grumble1965/FaradayRF-Hardware/Kicad-Faraday/ADC_Filters.sch

## KiCad design Kicad-Faraday/ADC_Filters.sch (2016-11-02)

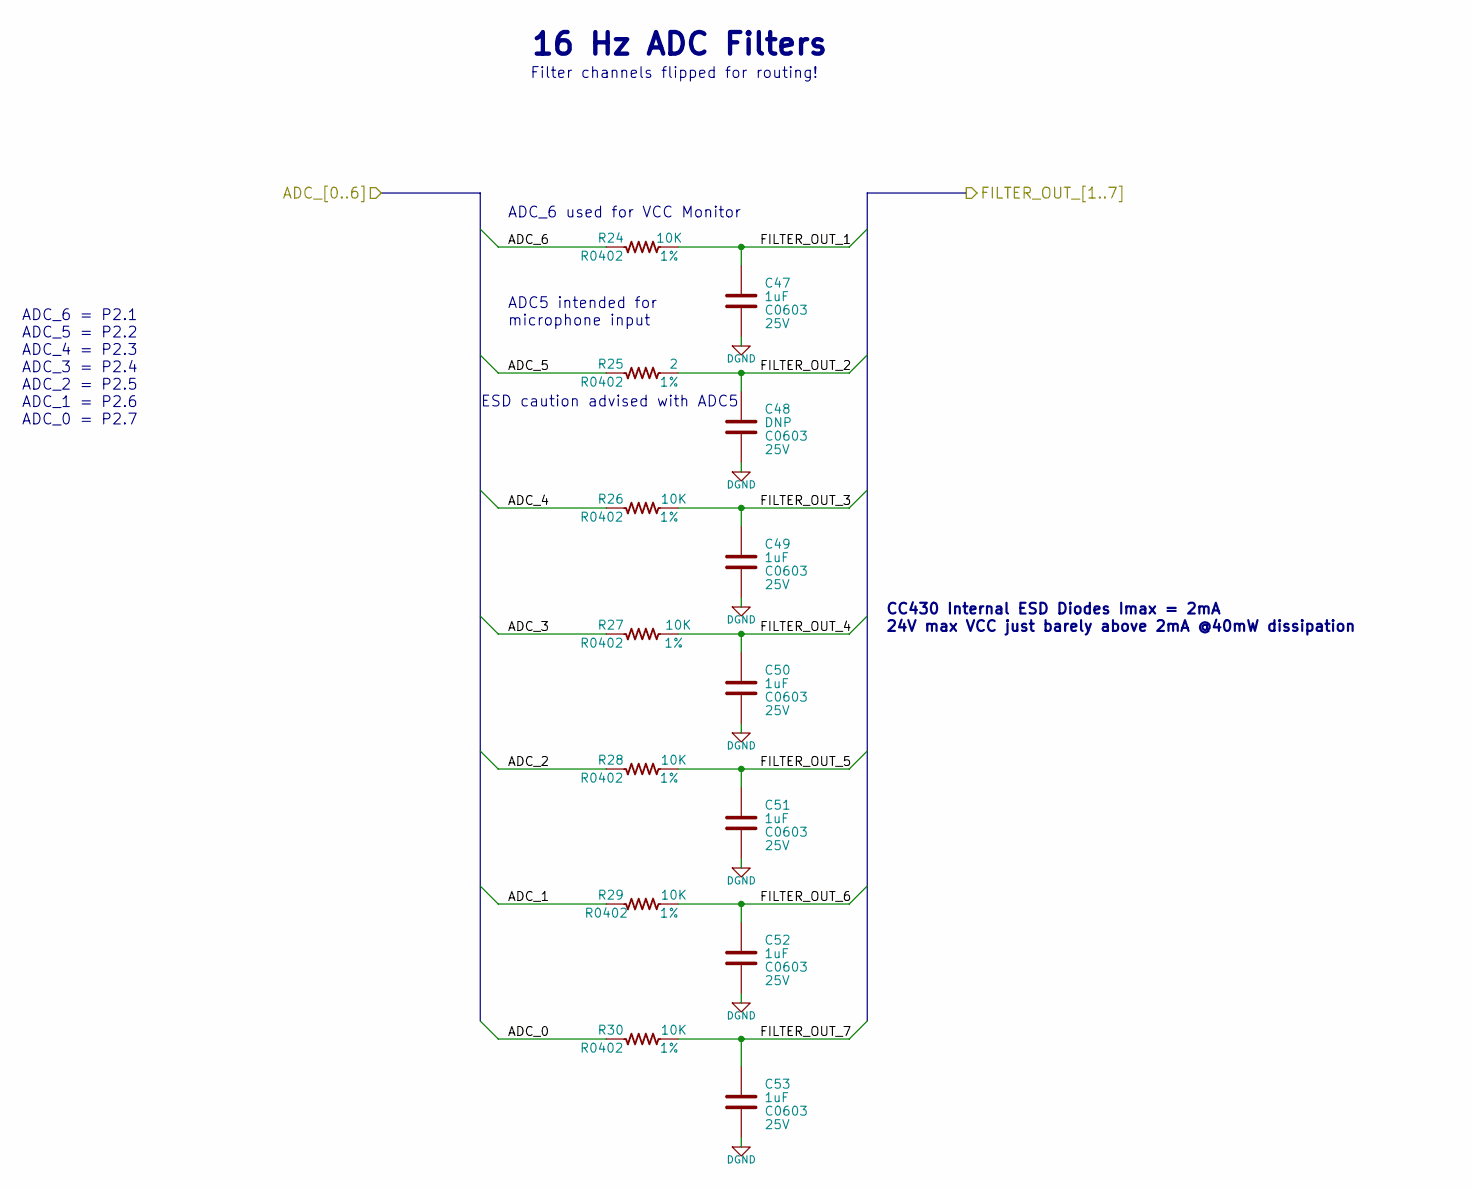
[picture p1: schematic ADC_Filters.sch]

Parts:
C47, C49, C50, C51, C52, C53: 1uF; C0603; Voltage 25V
C48: DNP; C0603; Voltage 25V
R24, R26, R27, R28, R29, R30: 10K; R0402; Tolerance 1%
R25: 2; R0402; Tolerance 1%

Connections:
ADC_0: R30.1
ADC_1: R29.1
ADC_2: R28.1
ADC_3: R27.1
ADC_4: R26.1
ADC_5: R25.1
ADC_6: R24.1
DGND: C47.2, C48.2, C49.2, C50.2, C51.2, C52.2, C53.2
FILTER_OUT_1: C47.1, R24.2
FILTER_OUT_2: C48.1, R25.2
FILTER_OUT_3: C49.1, R26.2
FILTER_OUT_4: C50.1, R27.2
FILTER_OUT_5: C51.1, R28.2
FILTER_OUT_6: C52.1, R29.2
FILTER_OUT_7: C53.1, R30.2

Notes on the sheet:
16 Hz ADC Filters
CC430 Internal ESD Diodes Imax = 2mA 24V max VCC just barely above 2mA @40mW dissipation
Filter channels flipped for routing!
ADC_6 used for VCC Monitor
ADC_6 = P2.1 ADC_5 = P2.2 ADC_4 = P2.3 ADC_3 = P2.4 ADC_2 = P2.5 ADC_1 = P2.6 ADC_0 = P2.7
ADC5 intended for microphone input
ESD caution advised with ADC5
