grumble1965/FaradayRF-Hardware/Kicad-Faraday/CC430.sch

## KiCad design Kicad-Faraday/CC430.sch (2016-11-02)

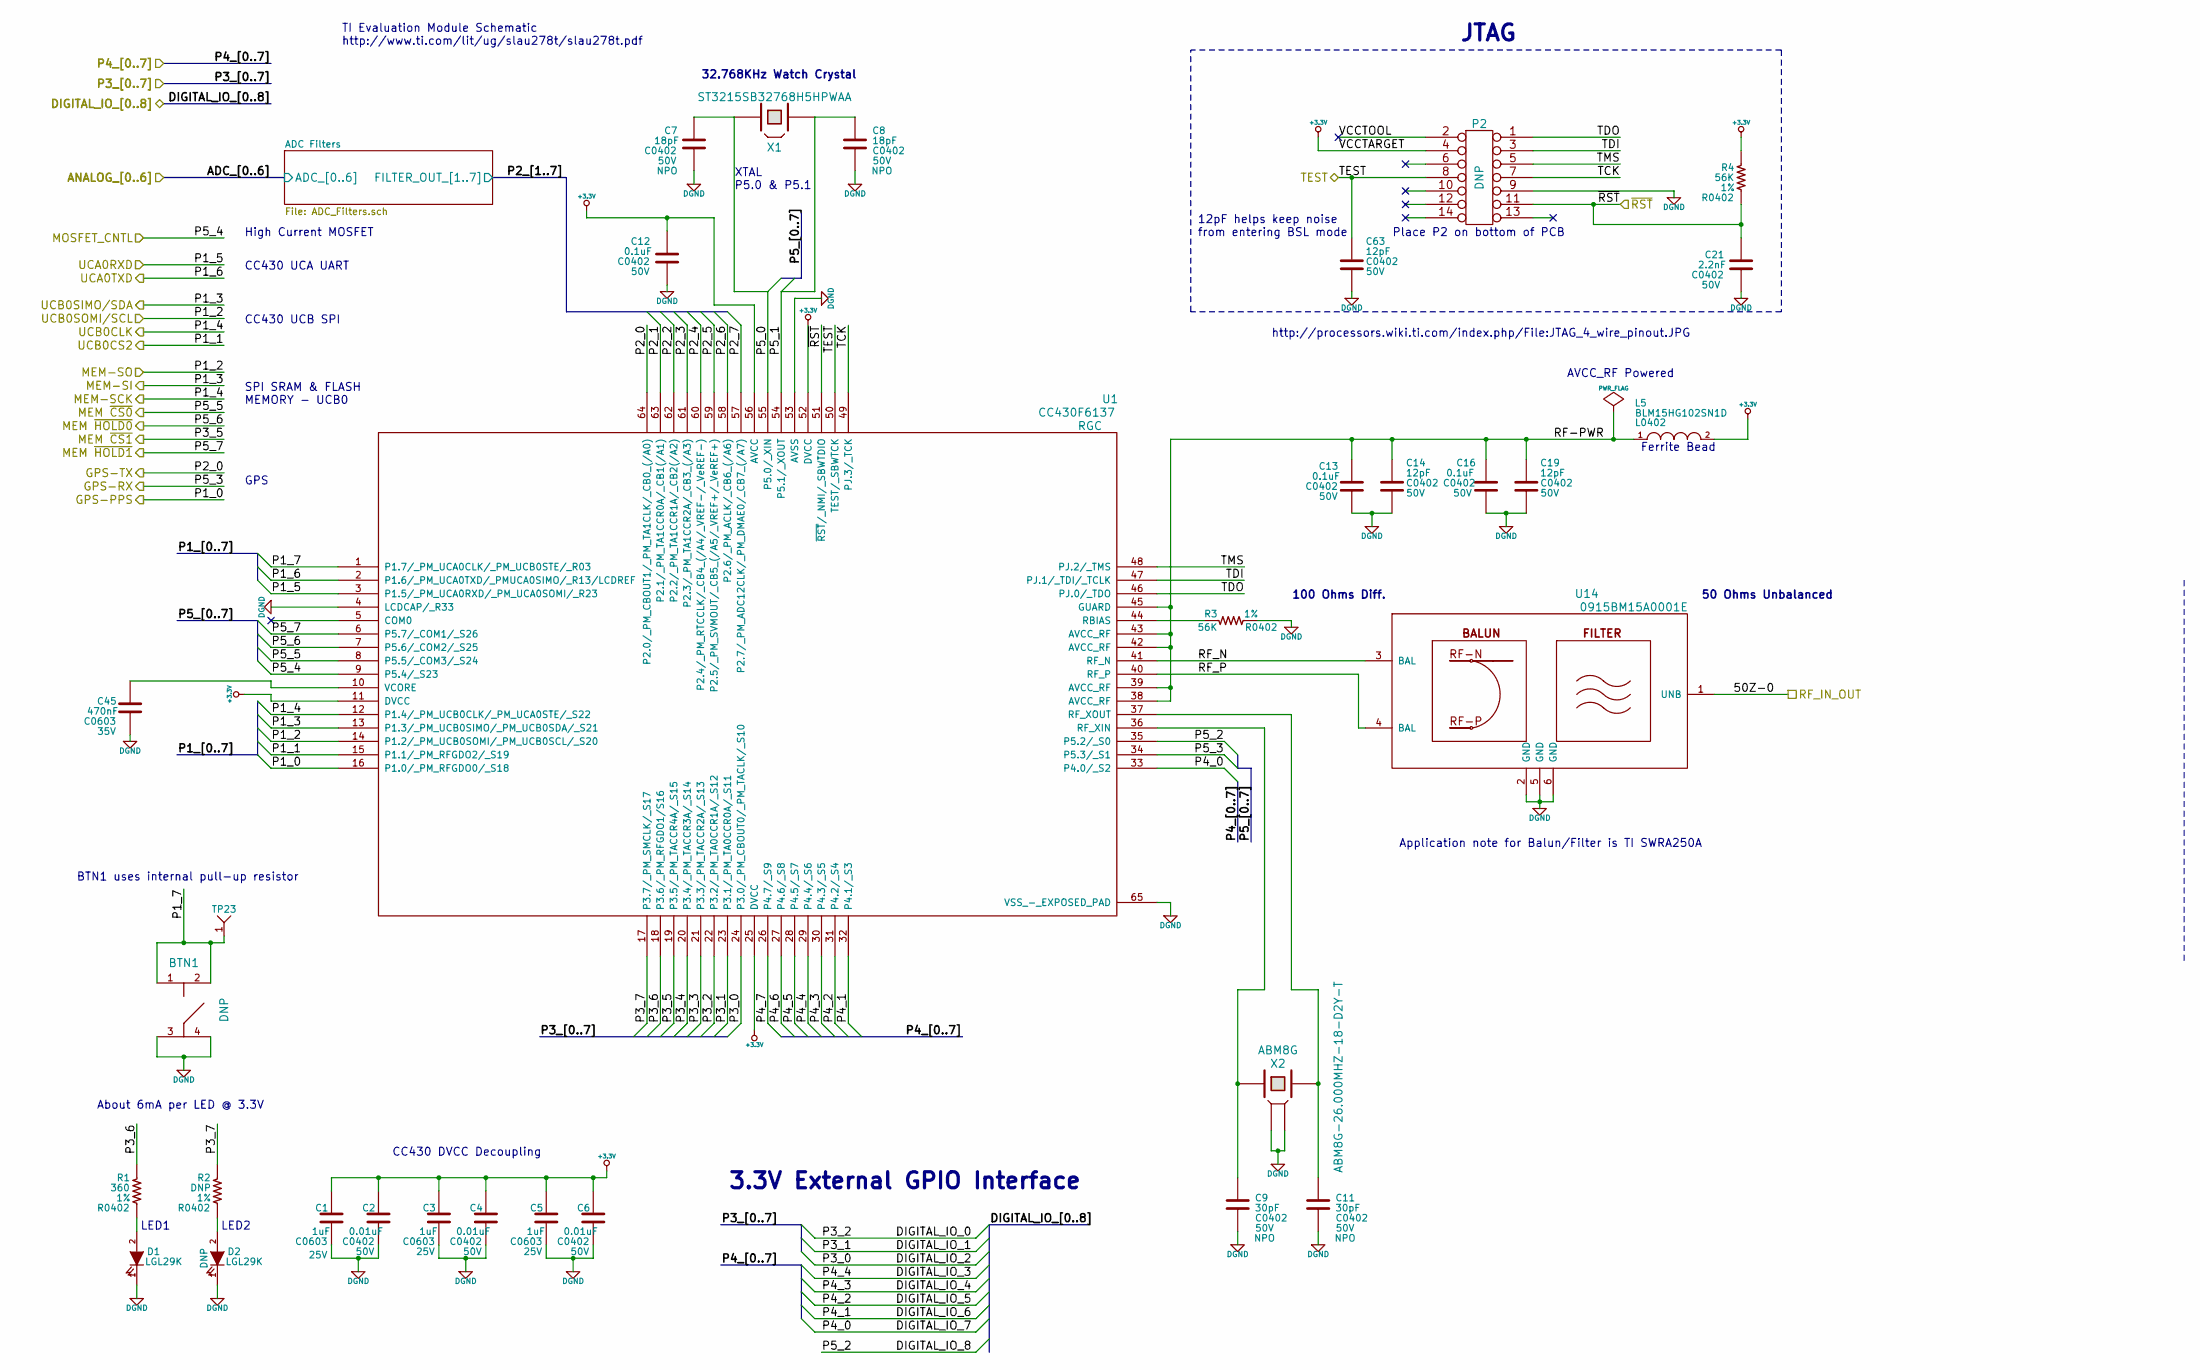
[picture p2: schematic CC430.sch]

Parts:
BTN1: DNP; PTS645-SMD
C1, C3, C5: 1uF; C0603; Voltage 25V
C2, C4, C6: 0.01uF; C0402; Voltage 50V
C7, C8: 18pF; C0402; Voltage 50V; Rating NPO
C9, C11: 30pF; C0402; Voltage 50V; Rating NPO
C12, C13, C16: 0.1uF; C0402; Voltage 50V
C14, C19, C63: 12pF; C0402; Voltage 50V
C21: 2.2nF; C0402; Voltage 50V
C45: 470nF; C0603; Voltage 35V
D1: LED-IPC; LGL29K
D2: DNP; LGL29K
L5: BLM15HG102SN1D; L0402
P2: DNP; 2514-6002UB
R1: 360; R0402; Tolerance 1%
R2: DNP; R0402; Tolerance 1%
R3, R4: 56K; R0402; Tolerance 1%
TP23: TEST-POINT; TEST-POINT-42MIL
U1: CC430F6137; RGC
U14: 0915BM15A0001E
X1: ST3215SB32768H5HPWAA
X2: ABM8G-26.000MHZ-18-D2Y-T; ABM8G

Connections:
50Z-0: U14.1 (UNB)
+3.3V: C1.1, C2.1, C3.1, C4.1, C5.1, C6.1, C12.1, L5.2, P2.4, R4.1, U1.11 (DVCC), U1.25 (DVCC), U1.52 (DVCC), U1.56 (AVCC)
DGND: BTN1.3, BTN1.4, C1.2, C2.2, C3.2, C4.2, C5.2, C6.2, C7.2, C8.2, C9.2, C11.2, C12.2, C13.2, C14.2, C16.2, C19.2, C21.2, C45.2, C63.2, D1.1 (C), D2.1 (C), P2.9, R3.2, U1.4 (LCDCAP/_R33), U1.53 (AVSS), U1.65 (VSS_-_EXPOSED_PAD), U14.2 (GND), U14.5 (GND), U14.6 (GND), X2.2, X2.4
DIGITAL_IO_0: U1.22 (P3.2/_PM_TA0CCR1A/_S12)
DIGITAL_IO_1: U1.23 (P3.1/_PM_TA0CCR0A/_S11)
DIGITAL_IO_2: U1.24 (P3.0/_PM_CBOUT0/_PM_TACLK/_S10)
DIGITAL_IO_3: U1.29 (P4.4/_S6)
DIGITAL_IO_4: U1.30 (P4.3/_S5)
DIGITAL_IO_5: U1.31 (P4.2/_S4)
DIGITAL_IO_6: U1.32 (P4.1/_S3)
DIGITAL_IO_7: U1.33 (P4.0/_S2)
DIGITAL_IO_8: U1.35 (P5.2/_S0)
GPS-PPS: U1.16 (P1.0/_PM_RFGDO0/_S18)
GPS-RX: U1.34 (P5.3/_S1)
GPS-TX: U1.64 (P2.0/_PM_CBOUT1/_PM_TA1CLK/_CB0_(/A0))
MEM ~CS0~: U1.8 (P5.5/_COM3/_S24)
MEM ~CS1~: U1.19 (P3.5/_PM_TACCR4A/_S15)
MEM ~HOLD0~: U1.7 (P5.6/_COM2/_S25)
MEM ~HOLD1~: U1.6 (P5.7/_COM1/_S26)
MEM-SCK: U1.12 (P1.4/_PM_UCB0CLK/_PM_UCA0STE/_S22)
MEM-SI: U1.13 (P1.3/_PM_UCB0SIMO/_PM_UCB0SDA/_S21)
MEM-SO: U1.14 (P1.2/_PM_UCB0SOMI/_PM_UCB0SCL/_S20)
MOSFET_CNTL: U1.9 (P5.4/_S23)
unnamed: C9.1, U1.36 (RF_XIN), X2.1
unnamed: C11.1, U1.37 (RF_XOUT), X2.3
unnamed: C45.1, U1.10 (VCORE)
unnamed: D1.2 (A), R1.2
unnamed: D2.2 (A), R2.2
unnamed: R3.1, U1.44 (RBIAS)
P1_1: U1.15 (P1.1/_PM_RFGDO2/_S19)
P1_5: U1.3 (P1.5/_PM_UCA0RXD/_PM_UCA0SOMI/_R23)
P1_6: U1.2 (P1.6/_PM_UCA0TXD/_PMUCA0SIMO/_R13/LCDREF)
P1_7: BTN1.1, BTN1.2, TP23.1, U1.1 (P1.7/_PM_UCA0CLK/_PM_UCB0STE/_R03)
P2_1: U1.63 (P2.1/_PM_TA1CCR0A/_CB1(/A1))
P2_2: U1.62 (P2.2/_PM_TA1CCR1A/_CB2(/A2))
P2_3: U1.61 (P2.3/_PM_TA1CCR2A/_CB3_(/A3))
P2_4: U1.60 (P2.4/_PM_RTCCLK/_CB4_(/A4/_VREF-/_VeREF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)
P2_5: U1.59 (P2.5/_PM_SVMOUT/_CB5_(/A5/_VREF+/_VeREF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)
P2_6: U1.58 (P2.6/_PM_ACLK/_CB6_(/A6))
P2_7: U1.57 (P2.7/_PM_ADC12CLK/_PM_DMAE0/_CB7_(/A7))
P3_3: U1.21 (P3.3/_PM_TACCR2A/_S13)
P3_4: U1.20 (P3.4/_PM_TACCR3A/_S14)
P3_6: R1.1, U1.18 (P3.6/_PM_RFGDO1/S16)
P3_7: R2.1, U1.17 (P3.7/_PM_SMCLK/_S17)
P4_5: U1.28 (P4.5/_S7)
P4_6: U1.27 (P4.6/_S8)
P4_7: U1.26 (P4.7/_S9)
P5_0: C7.1, U1.55 (P5.0/_XIN), X1.1
P5_1: C8.1, U1.54 (P5.1/_XOUT), X1.2
RF-PWR: C13.1, C14.1, C16.1, C19.1, L5.1, U1.38 (AVCC_RF), U1.39 (AVCC_RF), U1.42 (AVCC_RF), U1.43 (AVCC_RF), U1.45 (GUARD)
RF_N: U1.41 (RF_N), U14.3 (BAL)
RF_P: U1.40 (RF_P), U14.4 (BAL)
TCK: P2.7, U1.49 (PJ.3/_TCK)
TDI: P2.3, U1.47 (PJ.1/_TDI/_TCLK)
TDO: P2.1, U1.46 (PJ.0/_TDO)
TEST: C63.1, P2.8, U1.50 (TEST/_SBWTCK)
TMS: P2.5, U1.48 (PJ.2/_TMS)
VCCTOOL: P2.2
~RST~: C21.1, P2.11, R4.2, U1.51 (~RST~/_NMI/_SBWTDIO)

Notes on the sheet:
JTAG
CC430 UCA UART
CC430 UCB SPI
CC430 DVCC Decoupling
50 Ohms Unbalanced
AVCC_RF Powered
http://processors.wiki.ti.com/index.php/File:JTAG_4_wire_pinout.JPG
BTN1 uses internal pull-up resistor
LED1
LED2
TI Evaluation Module Schematic http://www.ti.com/lit/ug/slau278t/slau278t.pdf
About 6mA per LED @ 3.3V
3.3V External GPIO Interface
XTAL P5.0 & P5.1
32.768KHz Watch Crystal
Ferrite Bead
GPS
SPI SRAM & FLASH MEMORY - UCB0
High Current MOSFET
Place P2 on bottom of PCB
12pF helps keep noise from entering BSL mode
Application note for Balun/Filter is TI SWRA250A
100 Ohms Diff.
