grumble1965/FaradayRF-Hardware/Kicad-Faraday/FLASH.sch

## KiCad design Kicad-Faraday/FLASH.sch (2016-11-02)

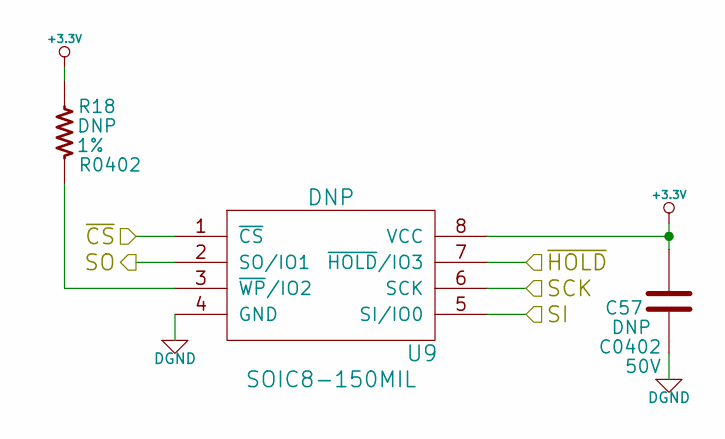
[picture p3: schematic FLASH.sch]

Parts:
C46: DNP; C0402; Voltage 50V
R18: DNP; R0402; Tolerance 1%
U9: DNP; SOIC8-150MIL

Connections:
+3.3V: C46.1, R18.2, U9.8 (VCC)
DGND: C46.2, U9.4 (GND)
unnamed: R18.1, U9.3 (~WP~/IO2)
SCK: U9.6 (SCK)
SI: U9.5 (SI/IO0)
SO: U9.2 (SO/IO1)
~CS~: U9.1 (~CS~)
~HOLD~: U9.7 (~HOLD~/IO3)
