grumble1965/FaradayRF-Hardware/Kicad-Faraday/Faraday.sch

## KiCad design Kicad-Faraday/Faraday.sch (2016-11-02)

Schematic: Faraday.sch

Parts:
FD1, FD2, FD3, FD4, FD5, FD6: FIDUCIAL; FD1
G1: OSHW
G2: FARADAYRF; FaradayRF
HDWR1, HDWR4, HDWR5, HDWR6: MOUSEBITE; BREAKAWAY-MIDDLE
P1: RF_FEMALE; CONSMA001-SMD-G

Notes on the sheet:
TX/RX referenced per chip CC430 RX <- FT230X TX CC430 TX -> FT230X RX
RF & Control Section
Connectors
USB <-> UART
Voltage Regulator
FaradayRF Wireless Module
SMA Connector
GPS Receiver
Manufacturing
