grumble1965/FaradayRF-Hardware/Kicad-Faraday/GPS.sch

## KiCad design Kicad-Faraday/GPS.sch (2016-11-02)

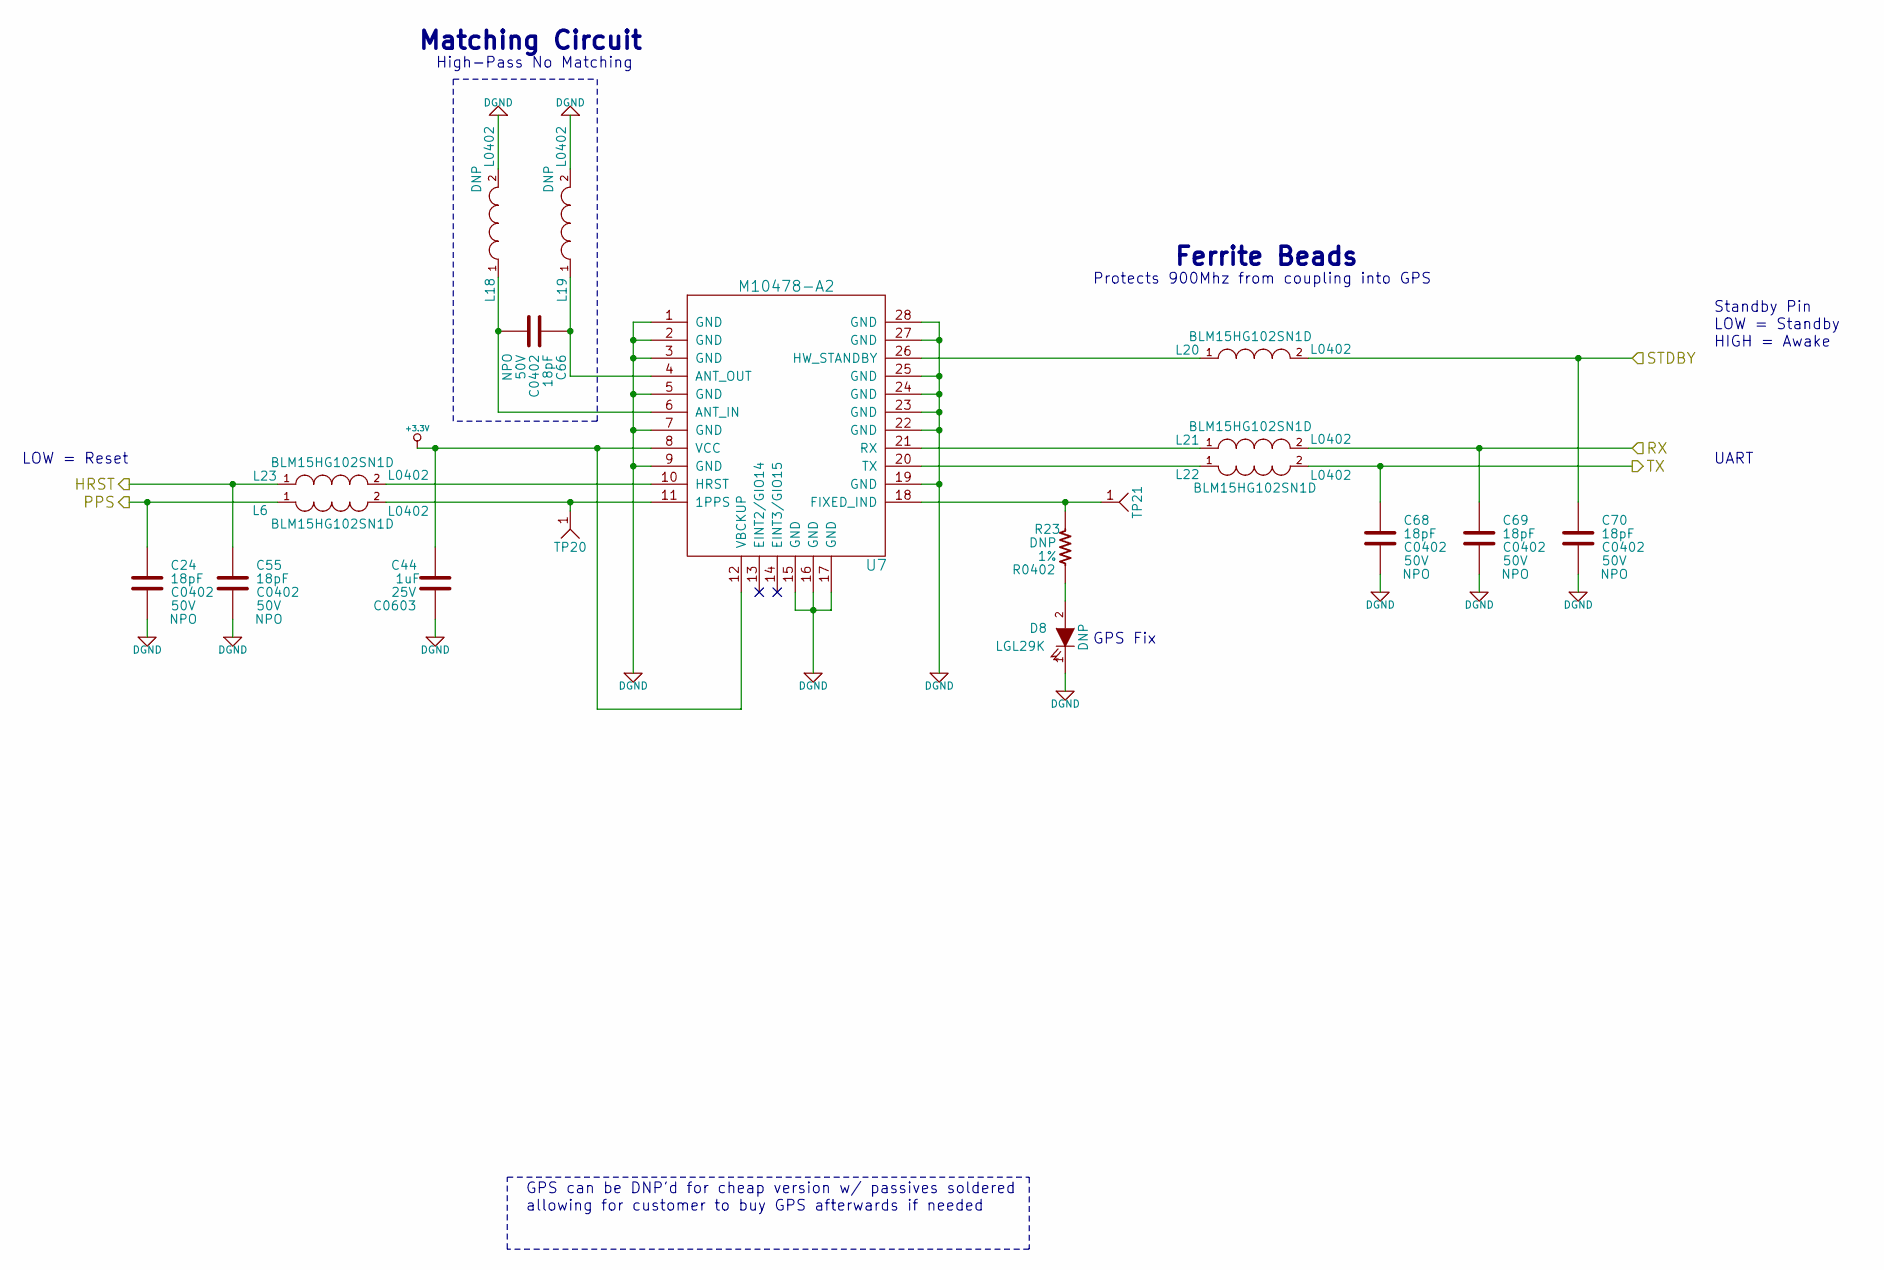
[picture p4: schematic GPS.sch]

Parts:
C24, C55, C66, C68, C69, C70: 18pF; C0402; Voltage 50V; Rating NPO
C44: 1uF; C0603; Voltage 25V
D8: DNP; LGL29K
L6, L20, L21, L22, L23: BLM15HG102SN1D; L0402
L18, L19: DNP; L0402
R23: DNP; R0402; Tolerance 1%
TP20, TP21: TEST-POINT; TEST-POINT-42MIL
U7: M10478-A2

Connections:
+3.3V: C44.1, U7.8 (VCC), U7.12 (VBCKUP)
DGND: C24.2, C44.2, C55.2, C68.2, C69.2, C70.2, D8.1 (C), L18.2, L19.2, U7.1 (GND), U7.2 (GND), U7.3 (GND), U7.5 (GND), U7.7 (GND), U7.9 (GND), U7.15 (GND), U7.16 (GND), U7.17 (GND), U7.19 (GND), U7.22 (GND), U7.23 (GND), U7.24 (GND), U7.25 (GND), U7.27 (GND), U7.28 (GND)
HRST: C55.1, L23.1
unnamed: C66.1, L19.1, U7.4 (ANT_OUT)
unnamed: C66.2, L18.1, U7.6 (ANT_IN)
unnamed: D8.2 (A), R23.2
unnamed: L6.2, TP20.1, U7.11 (1PPS)
unnamed: L20.1, U7.26 (HW_STANDBY)
unnamed: L21.1, U7.21 (RX)
unnamed: L22.1, U7.20 (TX)
unnamed: L23.2, U7.10 (HRST)
unnamed: R23.1, TP21.1, U7.18 (FIXED_IND)
PPS: C24.1, L6.1
RX: C69.1, L21.2
STDBY: C70.1, L20.2
TX: C68.1, L22.2

Notes on the sheet:
Ferrite Beads
GPS can be DNP'd for cheap version w/ passives soldered allowing for customer to buy GPS afterwards if needed
UART
Matching Circuit
High-Pass No Matching
Protects 900Mhz from coupling into GPS
Standby Pin LOW = Standby HIGH = Awake
GPS Fix
LOW = Reset
