grumble1965/FaradayRF-Hardware/Kicad-Faraday/MOSFET.sch

## KiCad design Kicad-Faraday/MOSFET.sch (2016-11-02)

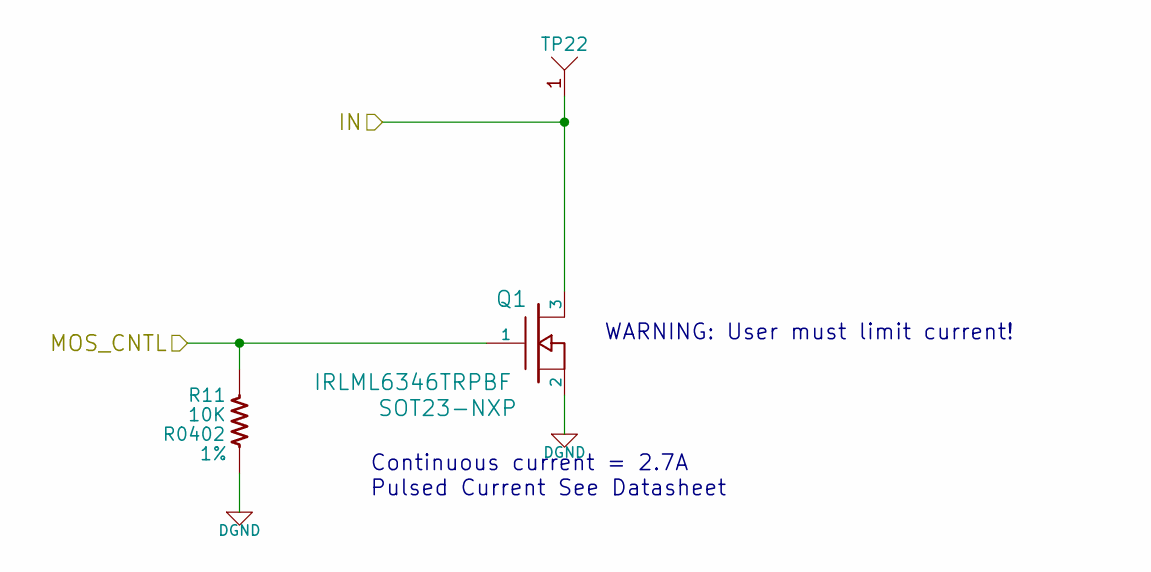
[picture p5: schematic MOSFET.sch]

Parts:
Q1: IRLML6346TRPBF; SOT23-NXP
R11: 10K; R0402; Tolerance 1%
TP22: TEST-POINT; TEST-POINT-42MIL

Connections:
DGND: Q1.2, R11.2
IN: Q1.3, TP22.1
MOS_CNTL: Q1.1, R11.1

Notes on the sheet:
WARNING: User must limit current!
Continuous current = 2.7A Pulsed Current See Datasheet
