grumble1965/FaradayRF-Hardware/Kicad-Faraday/PowerSupply.sch

## KiCad design Kicad-Faraday/PowerSupply.sch (2016-11-02)

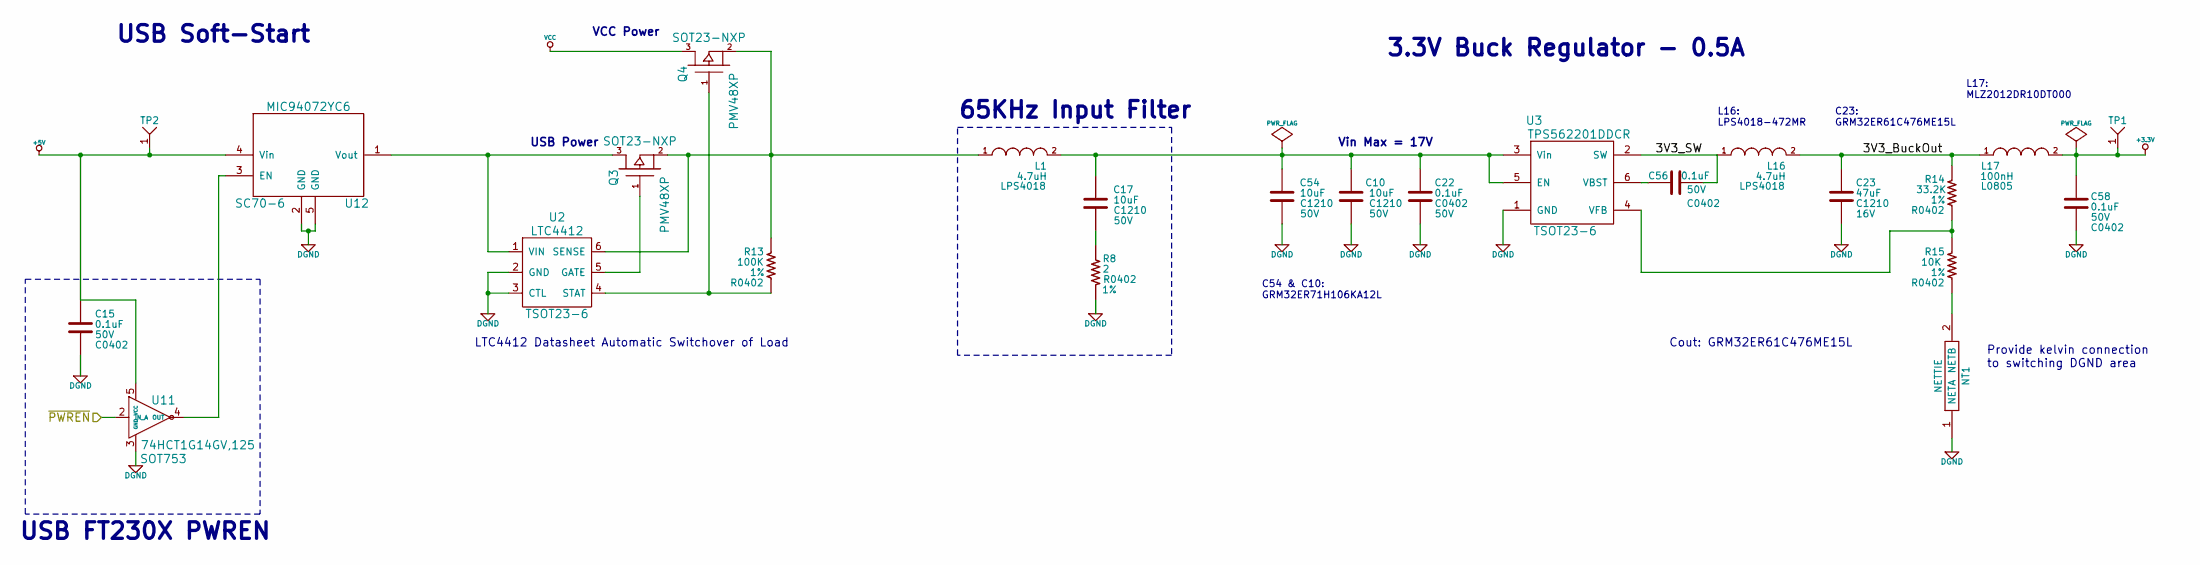
[picture p6: schematic PowerSupply.sch]

Parts:
C10, C17, C54: 10uF; C1210; Voltage 50V
C15, C22, C56, C58: 0.1uF; C0402; Voltage 50V
C23: 47uF; C1210; Voltage 16V
L1, L16: 4.7uH; LPS4018
L17: 100nH; L0805
NT1: NETTIE; NETTIE-0402
Q3, Q4: PMV48XP; SOT23-NXP
R8: 2; R0402; Tolerance 1%
R13: 100K; R0402; Tolerance 1%
R14: 33.2K; R0402; Tolerance 1%
R15: 10K; R0402; Tolerance 1%
TP1, TP2: TEST-POINT; TEST-POINT-42MIL
U2: LTC4412; TSOT23-6
U3: TPS562201DDCR; TSOT23-6
U11: 74HCT1G14GV,125; SOT753
U12: MIC94072YC6; SC70-6

Connections:
3V3_BuckOut: C23.1, L16.2, L17.1, R14.1
3V3_SW: C56.2, L16.1, U3.2 (SW)
+3.3V: C58.1, L17.2, TP1.1
+5V: C15.1, TP2.1, U11.5 (VCC), U12.4 (Vin)
DGND: C10.2, C15.2, C22.2, C23.2, C54.2, C58.2, NT1.1 (NETA), R8.1, U2.2 (GND), U2.3 (CTL), U3.1 (GND), U11.3 (GND), U12.2 (GND), U12.5 (GND)
unnamed: C10.1, C17.1, C22.1, C54.1, L1.2, U3.3 (Vin), U3.5 (EN)
unnamed: C17.2, R8.2
unnamed: C56.1, U3.6 (VBST)
unnamed: L1.1, Q3.2, Q4.2, R13.1, U2.6 (SENSE)
unnamed: NT1.2 (NETB), R15.2
unnamed: Q3.1, U2.5 (GATE)
unnamed: Q3.3, U2.1 (VIN), U12.1 (Vout)
unnamed: Q4.1, R13.2, U2.4 (STAT)
unnamed: R14.2, R15.1, U3.4 (VFB)
unnamed: U11.4 (OUT), U12.3 (EN)
VCC: Q4.3
~PWREN~: U11.2 (IN_A)

Notes on the sheet:
L16: LPS4018-472MR
3.3V Buck Regulator - 0.5A
Cout: GRM32ER61C476ME15L
C23: GRM32ER61C476ME15L
C54 & C10: GRM32ER71H106KA12L
L17: MLZ2012DR10DT000
USB Power
VCC Power
USB Soft-Start
Provide kelvin connection to switching DGND area
65KHz Input Filter
USB FT230X PWREN
Vin Max = 17V
LTC4412 Datasheet Automatic Switchover of Load
