grumble1965/FaradayRF-Hardware/Kicad-Faraday/RF_Front_End.sch

## KiCad design Kicad-Faraday/RF_Front_End.sch (2016-11-02)

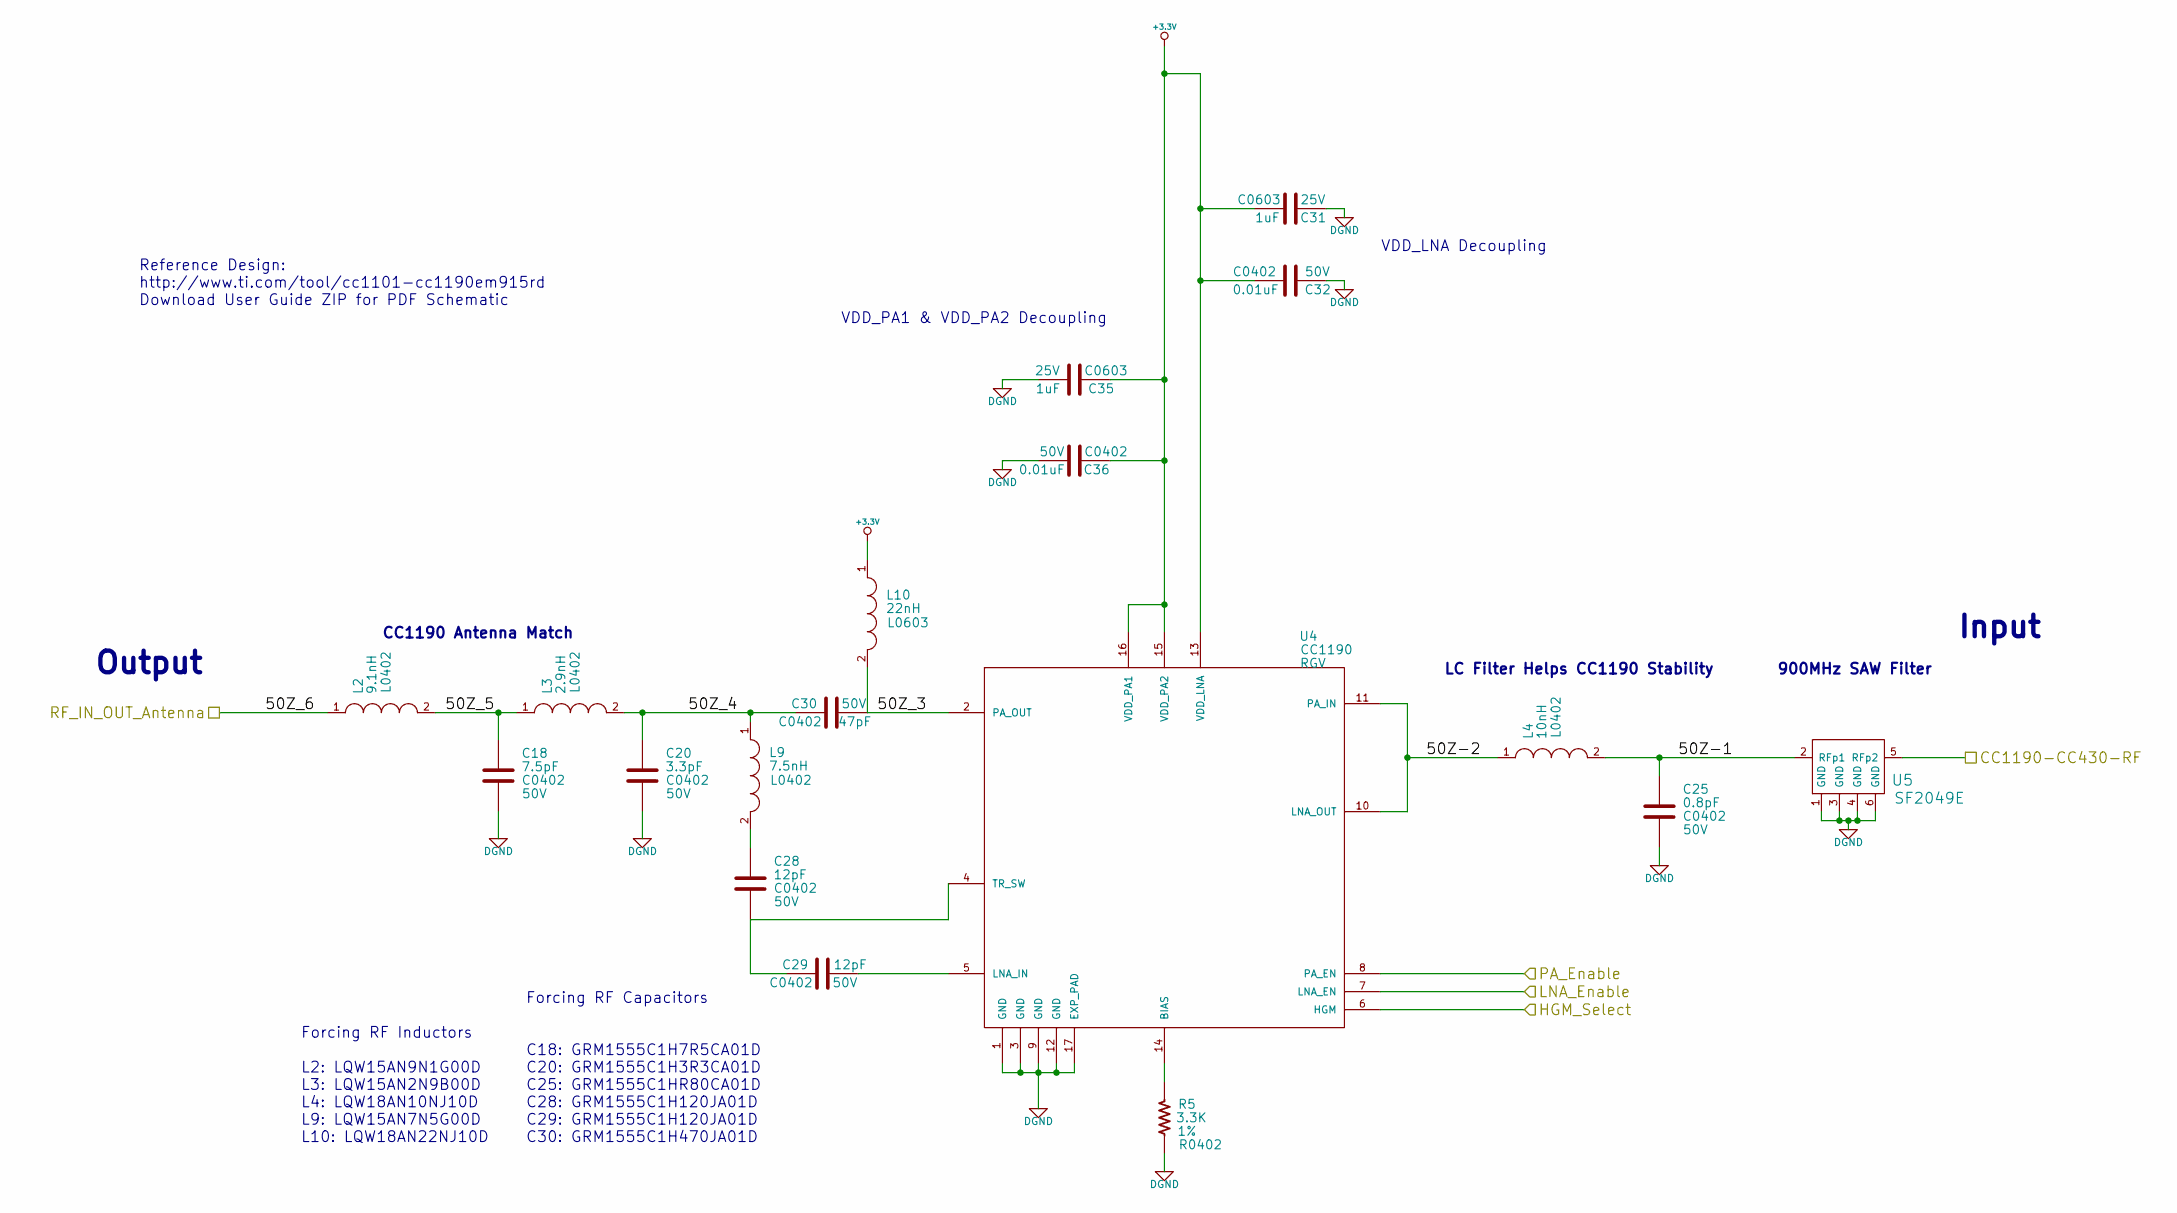
[picture p7: schematic RF_Front_End.sch]

Parts:
C18: 7.5pF; C0402; Voltage 50V
C20: 3.3pF; C0402; Voltage 50V
C25: 0.8pF; C0402; Voltage 50V
C28, C29: 12pF; C0402; Voltage 50V
C30: 47pF; C0402; Voltage 50V
C31, C35: 1uF; C0603; Voltage 25V
C32, C36: 0.01uF; C0402; Voltage 50V
L2: 9.1nH; L0402
L3: 2.9nH; L0402
L4: 10nH; L0402
L9: 7.5nH; L0402
L10: 22nH; L0603
R5: 3.3K; R0402; Tolerance 1%
U4: CC1190; RGV
U5: SF2049E

Connections:
50Z-1: C25.1, L4.2, U5.2 (RFp1)
50Z-2: L4.1, U4.10 (LNA_OUT), U4.11 (PA_IN)
50Z_3: C30.2, L10.2, U4.2 (PA_OUT)
50Z_4: C20.1, C30.1, L3.2, L9.1
50Z_5: C18.1, L2.2, L3.1
50Z_6: L2.1
+3.3V: C31.2, C32.2, C35.2, C36.2, L10.1, U4.13 (VDD_LNA), U4.15 (VDD_PA2), U4.16 (VDD_PA1)
CC1190-CC430-RF: U5.5 (RFp2)
DGND: C18.2, C20.2, C25.2, C31.1, C32.1, C35.1, C36.1, R5.2, U4.1 (GND), U4.3 (GND), U4.9 (GND), U4.12 (GND), U4.17 (EXP_PAD), U5.1 (GND), U5.3 (GND), U5.4 (GND), U5.6 (GND)
HGM_Select: U4.6 (HGM)
LNA_Enable: U4.7 (LNA_EN)
unnamed: C28.1, L9.2
unnamed: C28.2, C29.1, U4.4 (TR_SW)
unnamed: C29.2, U4.5 (LNA_IN)
unnamed: R5.1, U4.14 (BIAS)
PA_Enable: U4.8 (PA_EN)

Notes on the sheet:
CC1190 Antenna Match
Reference Design: http://www.ti.com/tool/cc1101-cc1190em915rd Download User Guide ZIP for PDF Schematic
VDD_PA1 & VDD_PA2 Decoupling
VDD_LNA Decoupling
900MHz SAW Filter
Input
Output
Forcing RF Inductors L2: LQW15AN9N1G00D L3: LQW15AN2N9B00D L4: LQW18AN10NJ10D L9: LQW15AN7N5G00D L10: LQW18AN22NJ10D
Forcing RF Capacitors C18: GRM1555C1H7R5CA01D C20: GRM1555C1H3R3CA01D C25: GRM1555C1HR80CA01D C28: GRM1555C1H120JA01D C29: GRM1555C1H120JA01D C30: GRM1555C1H470JA01D
LC Filter Helps CC1190 Stability
