grumble1965/FaradayRF-Hardware/Kicad-Faraday/SRAM.sch

## KiCad design Kicad-Faraday/SRAM.sch (2016-11-02)

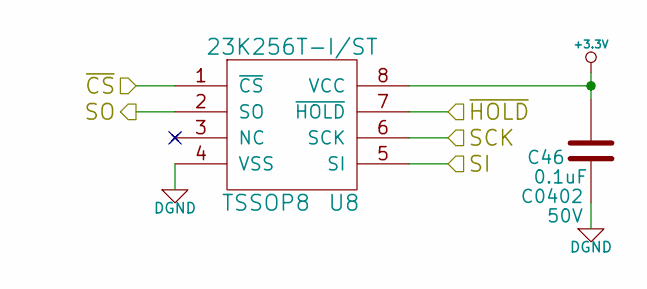
[picture p8: schematic SRAM.sch]

Parts:
C46: 0.1uF; C0402; Voltage 50V
U8: 23K256T-I/ST; TSSOP8

Connections:
+3.3V: C46.1, U8.8 (VCC)
DGND: C46.2, U8.4 (VSS)
SCK: U8.6 (SCK)
SI: U8.5 (SI)
SO: U8.2 (SO)
~CS~: U8.1 (~CS~)
~HOLD~: U8.7 (~HOLD~)
