grumble1965/FaradayRF-Hardware/Kicad-Faraday/USBtoSerial.sch

## KiCad design Kicad-Faraday/USBtoSerial.sch (2016-11-02)

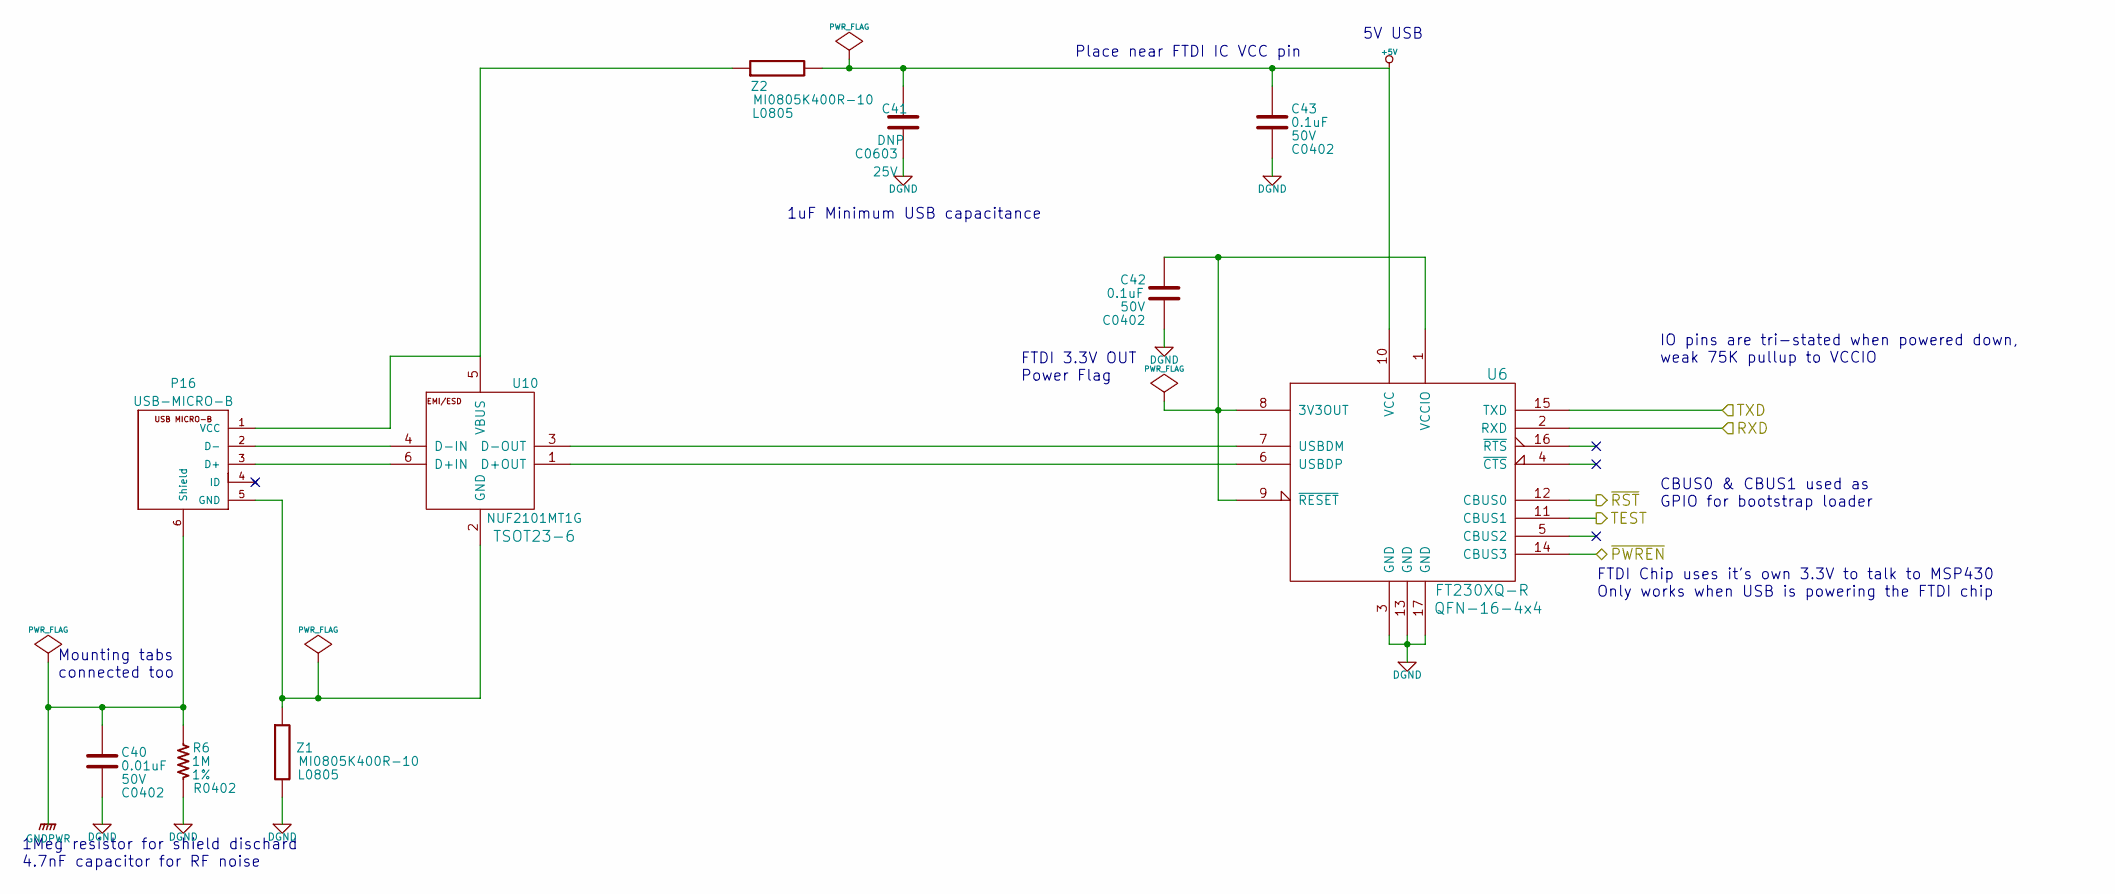
[picture p9: schematic USBtoSerial.sch]

Parts:
C40: 0.01uF; C0402; Voltage 50V
C41: DNP; C0603; Voltage 25V
C42, C43: 0.1uF; C0402; Voltage 50V
P16: USB-MICRO-B; 10118192-0001LF
R6: 1M; R0402; Tolerance 1%
U6: FT230XQ-R; QFN-16-4x4
U10: NUF2101MT1G; TSOT23-6
Z1, Z2: MI0805K400R-10; L0805

Connections:
+5V: C41.1, C43.1, U6.10 (VCC), Z2.2
DGND: C40.2, C41.2, C42.2, C43.2, R6.1, U6.3 (GND), U6.13 (GND), U6.17 (GND), Z1.2
GNDPWR: C40.1, P16.6 (Shield), R6.2
unnamed: C42.1, U6.1 (VCCIO), U6.8 (3V3OUT), U6.9 (~RESET~)
unnamed: P16.1 (VCC), U10.5 (VBUS), Z2.1
unnamed: P16.2 (D-), U10.4 (D-IN)
unnamed: P16.3 (D+), U10.6 (D+IN)
unnamed: P16.5 (GND), U10.2 (GND), Z1.1
unnamed: U6.6 (USBDP), U10.1 (D+OUT)
unnamed: U6.7 (USBDM), U10.3 (D-OUT)
RXD: U6.2 (RXD)
TEST: U6.11 (CBUS1)
TXD: U6.15 (TXD)
~PWREN~: U6.14 (CBUS3)
~RST~: U6.12 (CBUS0)

Notes on the sheet:
Place near FTDI IC VCC pin
FTDI Chip uses it's own 3.3V to talk to MSP430 Only works when USB is powering the FTDI chip
5V USB
FTDI 3.3V OUT Power Flag
1uF Minimum USB capacitance
CBUS0 & CBUS1 used as GPIO for bootstrap loader
Mounting tabs connected too
1Meg resistor for shield dischard 4.7nF capacitor for RF noise
IO pins are tri-stated when powered down, weak 75K pullup to VCCIO
