grumble1965/FaradayRF-Hardware/Kicad-Faraday/connector.sch

## KiCad design Kicad-Faraday/connector.sch (2016-11-02)

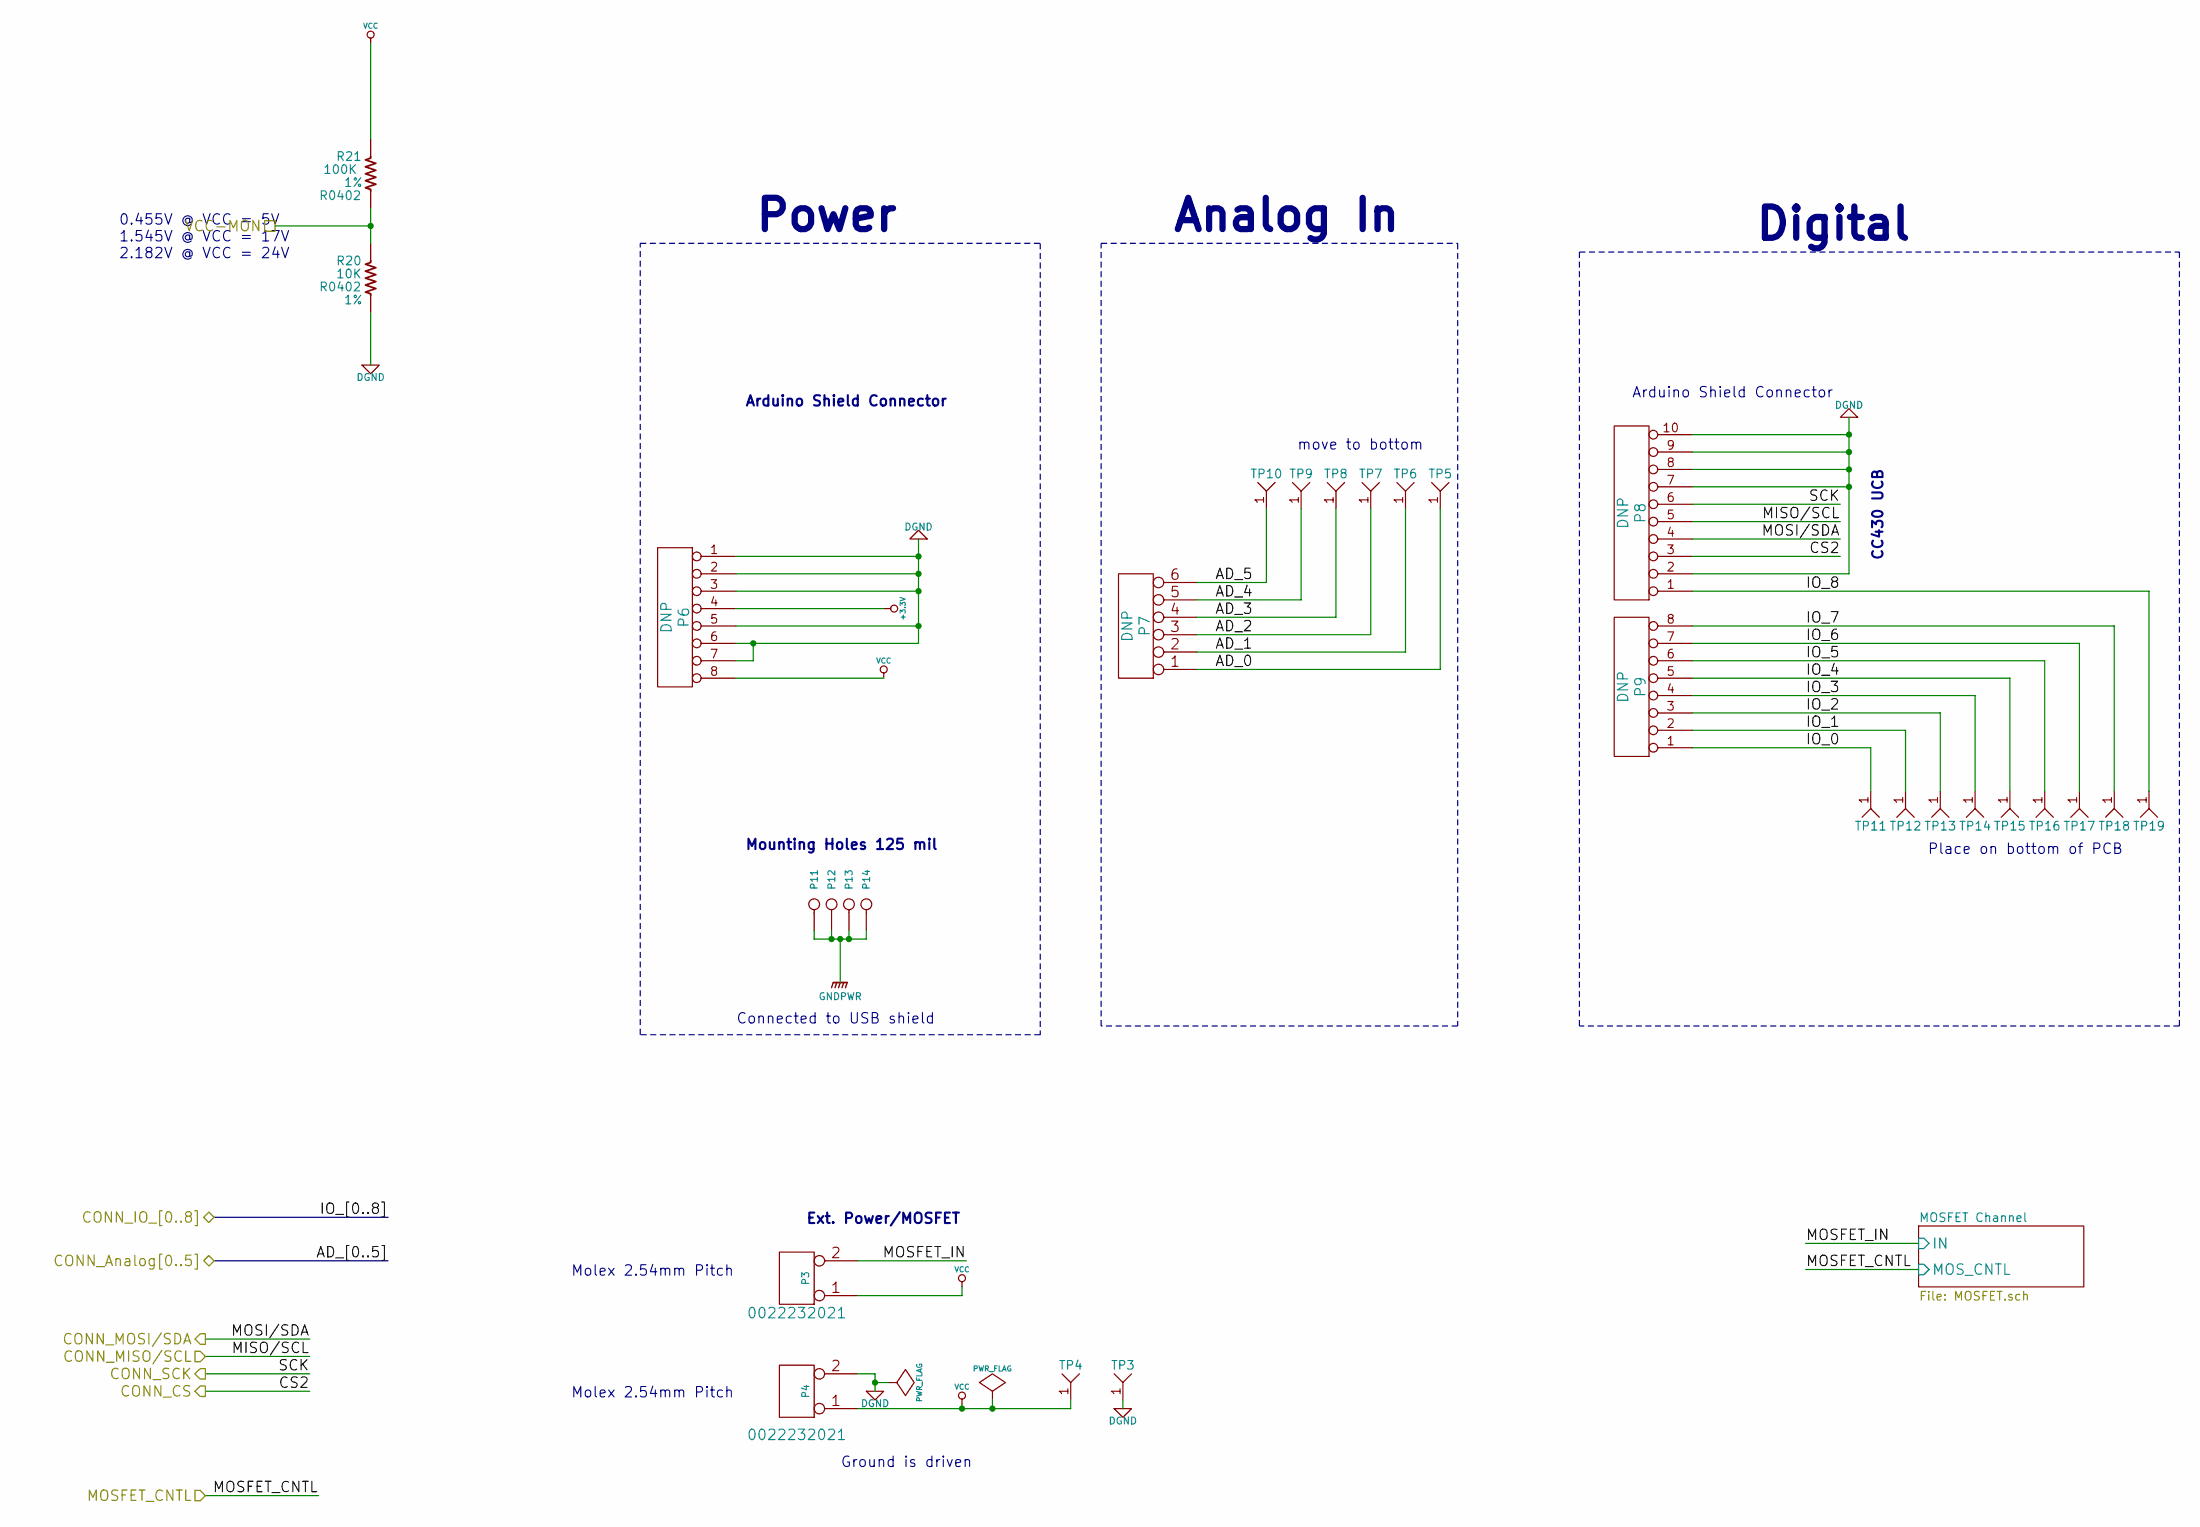
[picture p10: schematic connector.sch]

Parts:
P3, P4: DNP; 0022232021
P6, P9: DNP; SIL-8
P7: DNP; SIL-6
P8: DNP; SIL-10
P11, P12, P13, P14: DNP; MTH-4-40-Tight
R20: 10K; R0402; Tolerance 1%
R21: 100K; R0402; Tolerance 1%
TP3, TP4, TP5, TP6, TP7, TP8, TP9, TP10, TP11, TP12, TP13, TP14, TP15, TP16, TP17, TP18, TP19: TEST-POINT; TEST-POINT-42MIL

Connections:
+3.3V: P6.4
AD_0: P7.1, TP5.1
AD_1: P7.2, TP6.1
AD_2: P7.3, TP7.1
AD_3: P7.4, TP8.1
AD_4: P7.5, TP9.1
AD_5: P7.6, TP10.1
CONN_CS: P8.3
CONN_MISO/SCL: P8.5
CONN_MOSI/SDA: P8.4
CONN_SCK: P8.6
DGND: P4.2 (PM), P6.1, P6.2, P6.3, P6.5, P6.6, P6.7, P8.2, P8.7, P8.8, P8.9, P8.10, R20.2, TP3.1
GNDPWR: P11.1, P12.1, P13.1, P14.1
IO_0: P9.1, TP11.1
IO_1: P9.2, TP12.1
IO_2: P9.3, TP13.1
IO_3: P9.4, TP14.1
IO_4: P9.5, TP15.1
IO_5: P9.6, TP16.1
IO_6: P9.7, TP17.1
IO_7: P9.8, TP18.1
IO_8: P8.1, TP19.1
MOSFET_IN: P3.2 (PM)
VCC: P3.1, P4.1, P6.8, R21.1, TP4.1
VCC-MON: R20.1, R21.2

Notes on the sheet:
Power
Analog In
Digital
Arduino Shield Connector
Mounting Holes 125 mil
Molex 2.54mm Pitch
Ext. Power/MOSFET
Connected to USB shield
CC430 UCB
0.455V @ VCC = 5V 1.545V @ VCC = 17V 2.182V @ VCC = 24V
move to bottom
Place on bottom of PCB
Ground is driven
